olijuseju/videocoche/Jors_1/360Robot/Pinout Schematic.jpg

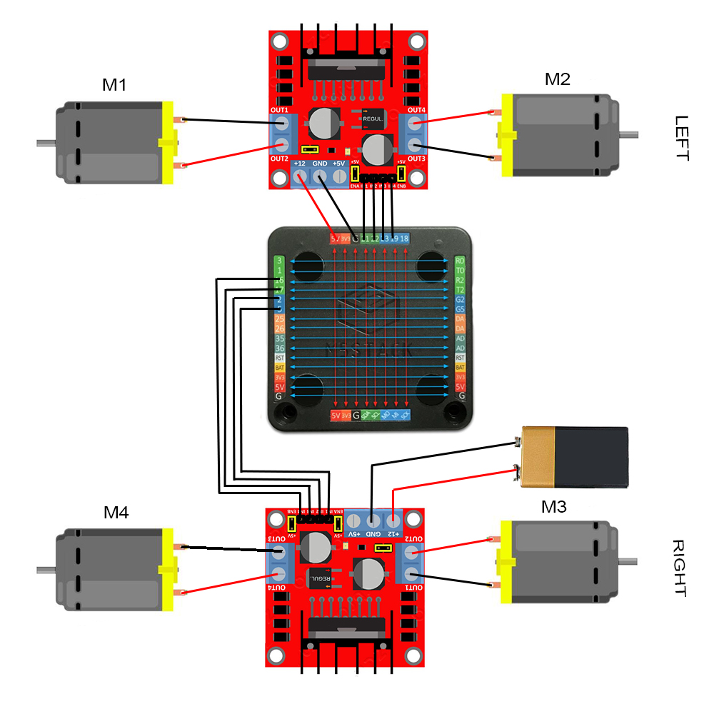
Jors_1/360Robot/Pinout Schematic.jpg
