olijuseju/videocoche/Jors_1/360Robot/README.md

# 360Robot
# Why 360Robot?
This project was born from the need to remotely control the movement of a camera for making 360º videos . With the aim of obtaining a recording at eye level without the need of human resources. It consists in the design and construction of a motorized mobile support remotely controlled by wireless connection. This type of recording technology is becoming really popular and we wanted to be part of this movement.

# How did we make it?
Our first idea was to make it using Arduino Genuino Uno with ESP32 chip, however we wanted to make it different. So instead of that we decided to use M5STACK which is an open source enclosed modular toolkit with ESP32:

http://m5stack.com/.

We also used 2 motor shields, each one for 2 motors:

https://www.iberobotics.com/producto/modulo-driver-motores-l298n-doble-puente-h/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

Last but not least, the robot tank. Which includes the chassis and the motors for the robot:

https://es.aliexpress.com/item/T900-4WD-Metal-Wall-E-Tank-Track-Caterpillar-Chassis-tracked-vehicle-mobile-platform-crawler-walee-diy/32669806063.html

# Design Diagram
360robot 5

# Pinout Schematic
pinout schematic
