olijuseju/videocoche/conexionado.PNG

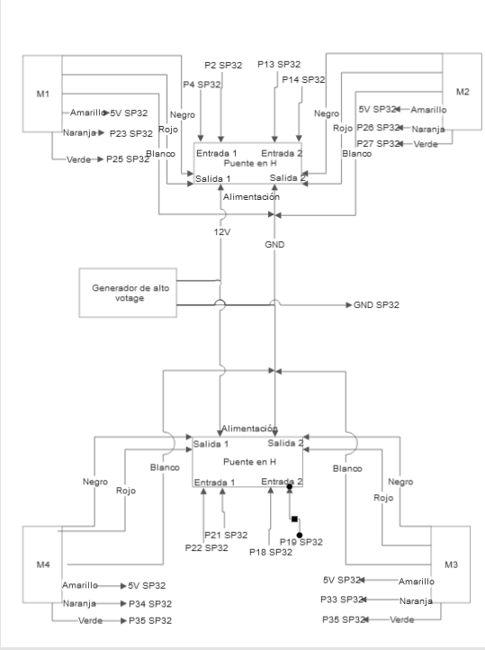
conexionado.PNG
