olijuseju/videocoche/Jors_1/360Robot/360Robot Diagram.png

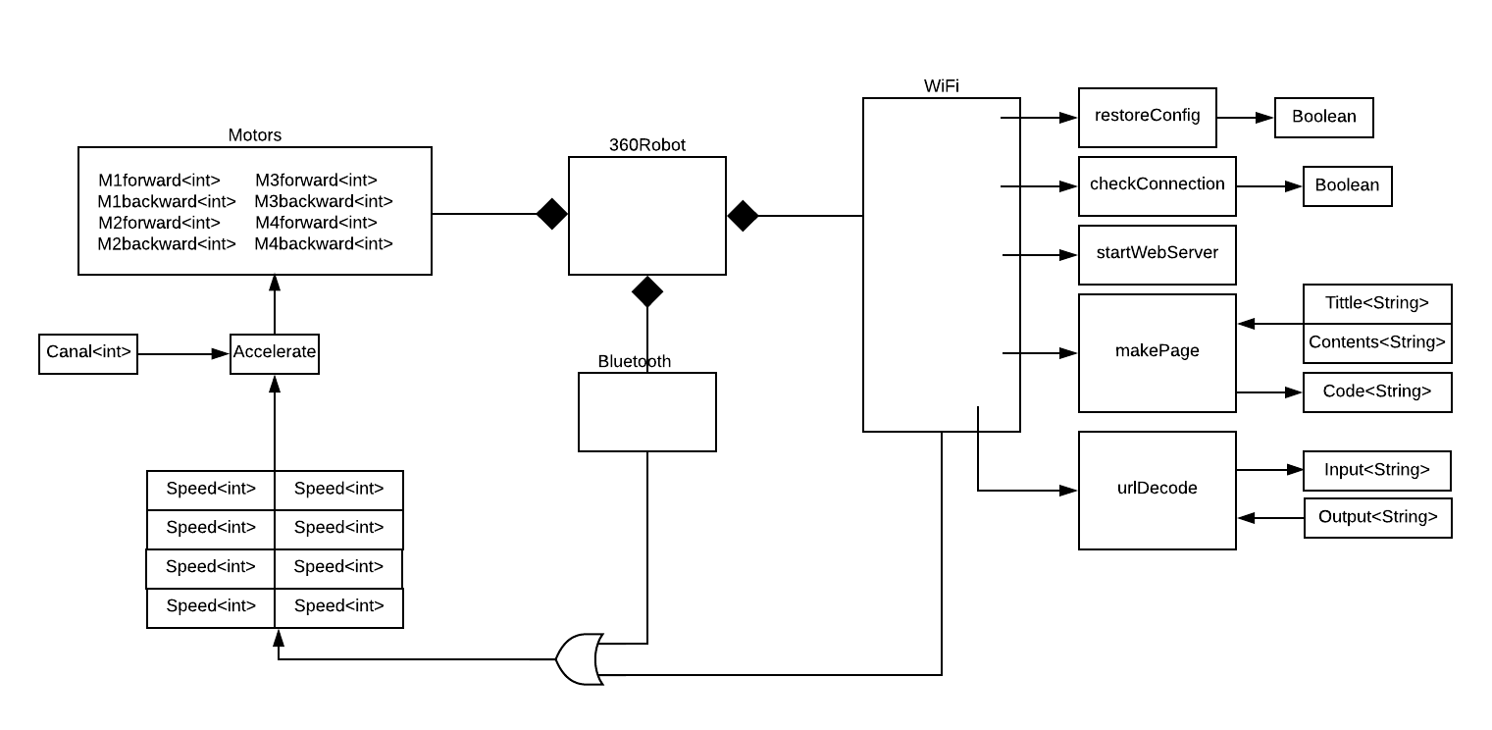
Jors_1/360Robot/360Robot Diagram.png
