olijuseju/videocoche/Jors_1/360Robot/360WebClient/8.png

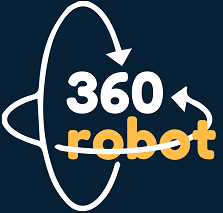
Jors_1/360Robot/360WebClient/8.png
