olijuseju/videocoche/material.xlsx

Material | Cantidad | Observaciones
Controladores ESP32-WROOM-32 Adafruit | 4
Controladores ESP32s Sparkfun | 1 | Está siendo utilizado en la primera versión del robot
Rollo de cable blanco 100m | 1
Rollo de cable negro 100m | 3
Rollo de cable rojo 100m | 1
Contactos terminales para crimpar cables | 100 | Se han utilizado aproximadamente 20
Paquete de 10 resistencias | 10 | De valores desde 100 Ω a 1MΩ
Conectores , PH, Receptáculo, 6 Vías, 2 mm | 10 | Se han utilizado 4 para el montaje del robot
Virolas para cables | 2000 | Colores: Blanco (0.5mm2) Gris (0.75mm2) Rojo (1mm2) Negro (1.5mm2) Azul (2.5mm2) Gris claro (4mm2) Amarillo (6mm2) Rojo (10mm2)
Crimpadora de cables para virolas | 1 | Utilizado para crimpar los cables a las virolas, no a los conectores
Peladora de cables | 1
Destornillador | 1 | Con 14 puntas diferentes
Cutter | 1
Contactos para PCB 10 vías | 10 | Usados 2 en la pcb
Contactos para PCB 3 vías | 10 | Usado 1 en la pcb
Condensadores de 1μF y 6.3V para soldar en PCB | 10 | 1 usado en la PCB
