olijuseju/videocoche/conexiones_videocoche.pdf

+

# BATERIA

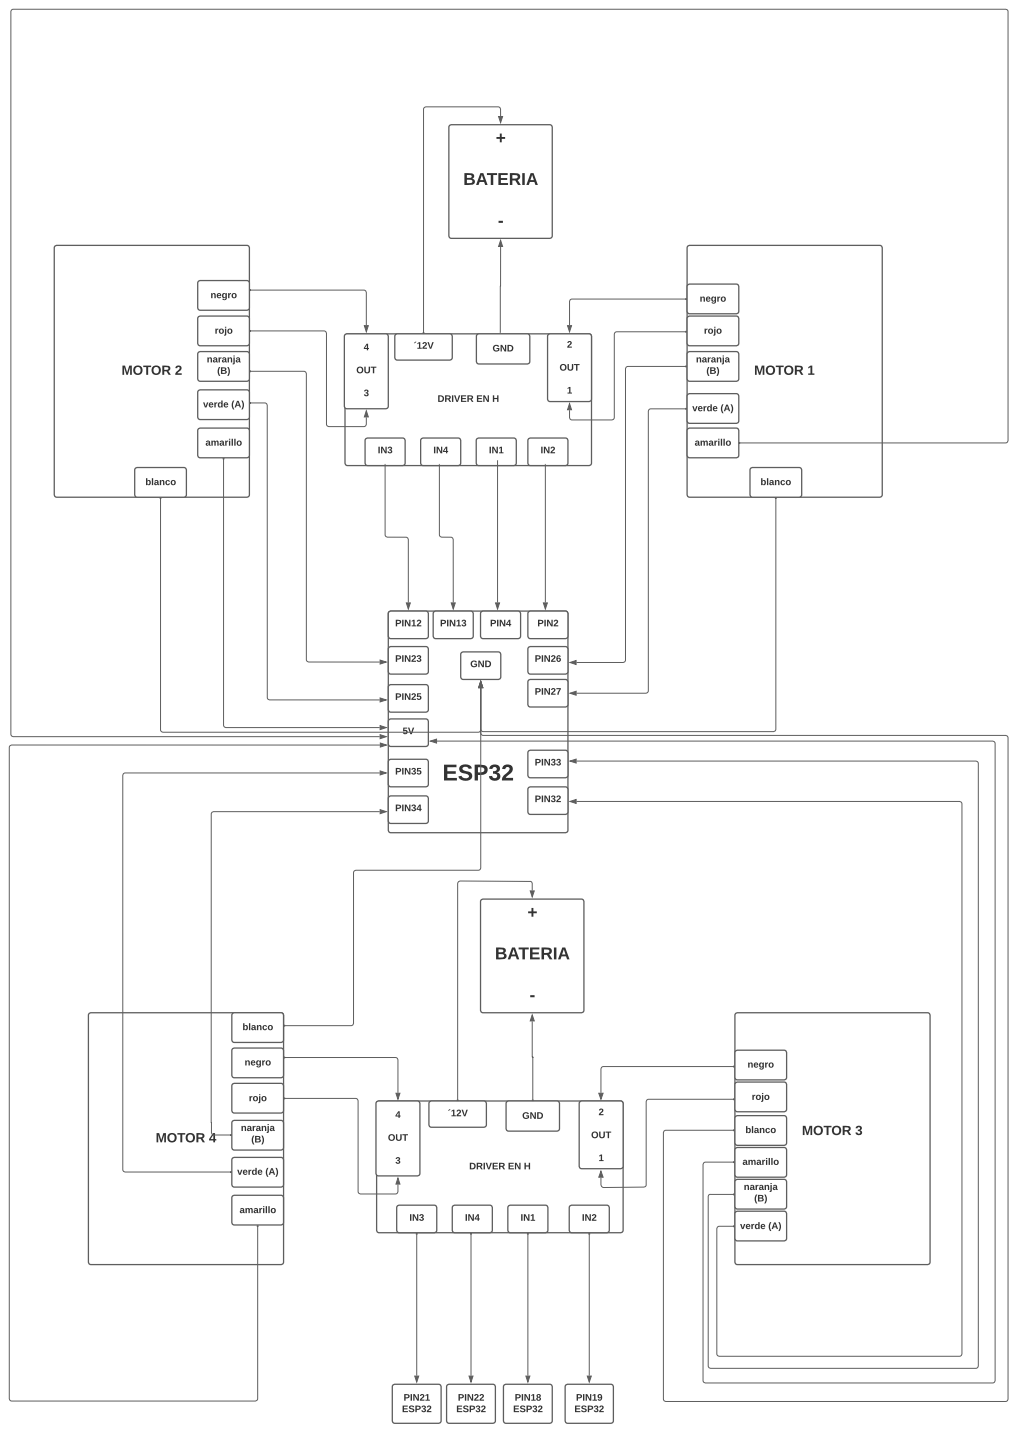
[picture p8: page 1]
ESP32; PIN12; PIN13; PIN4; PIN2; DRIVER EN H; OUT; MOTOR 2; blanco; negro; naranja (B); rojo; verde (A); amarillo; MOTOR 1; PIN25; PIN23; GND; MOTOR 4; MOTOR 3; BATERIA; PIN35; PIN34; PIN27; PIN26 GND; PIN33; PIN32; PIN21 ESP32; PIN22 ESP32; PIN18 ESP32; PIN19 ESP32
