olijuseju/videocoche/Robot fernando.pdf

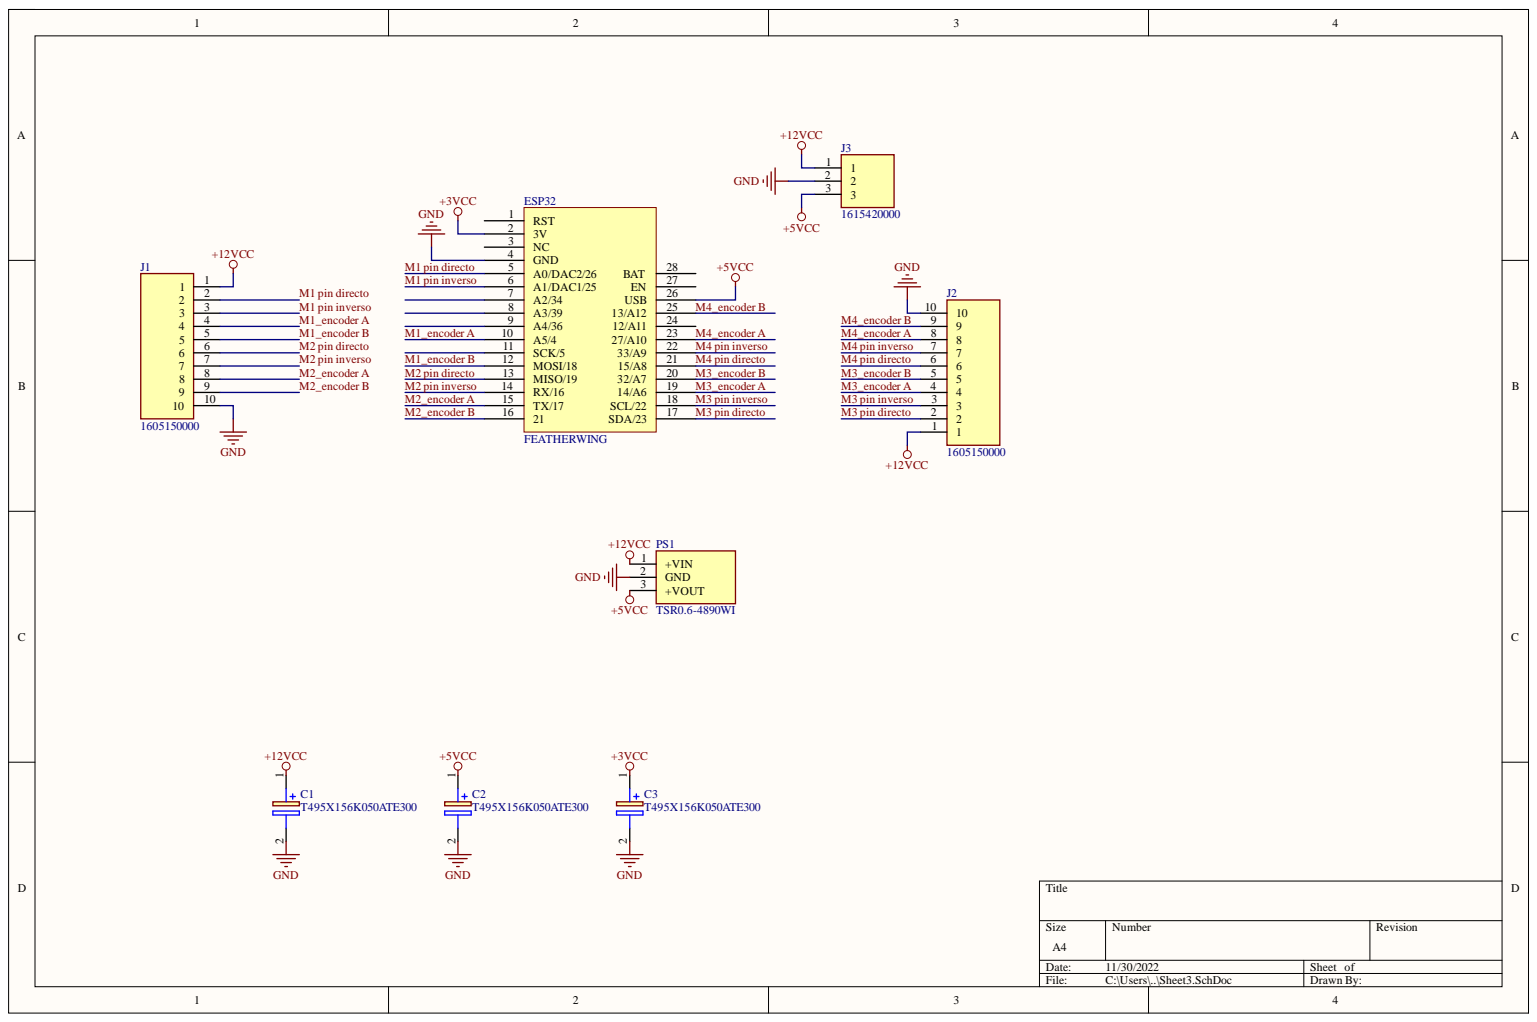
[picture p9: page 1]

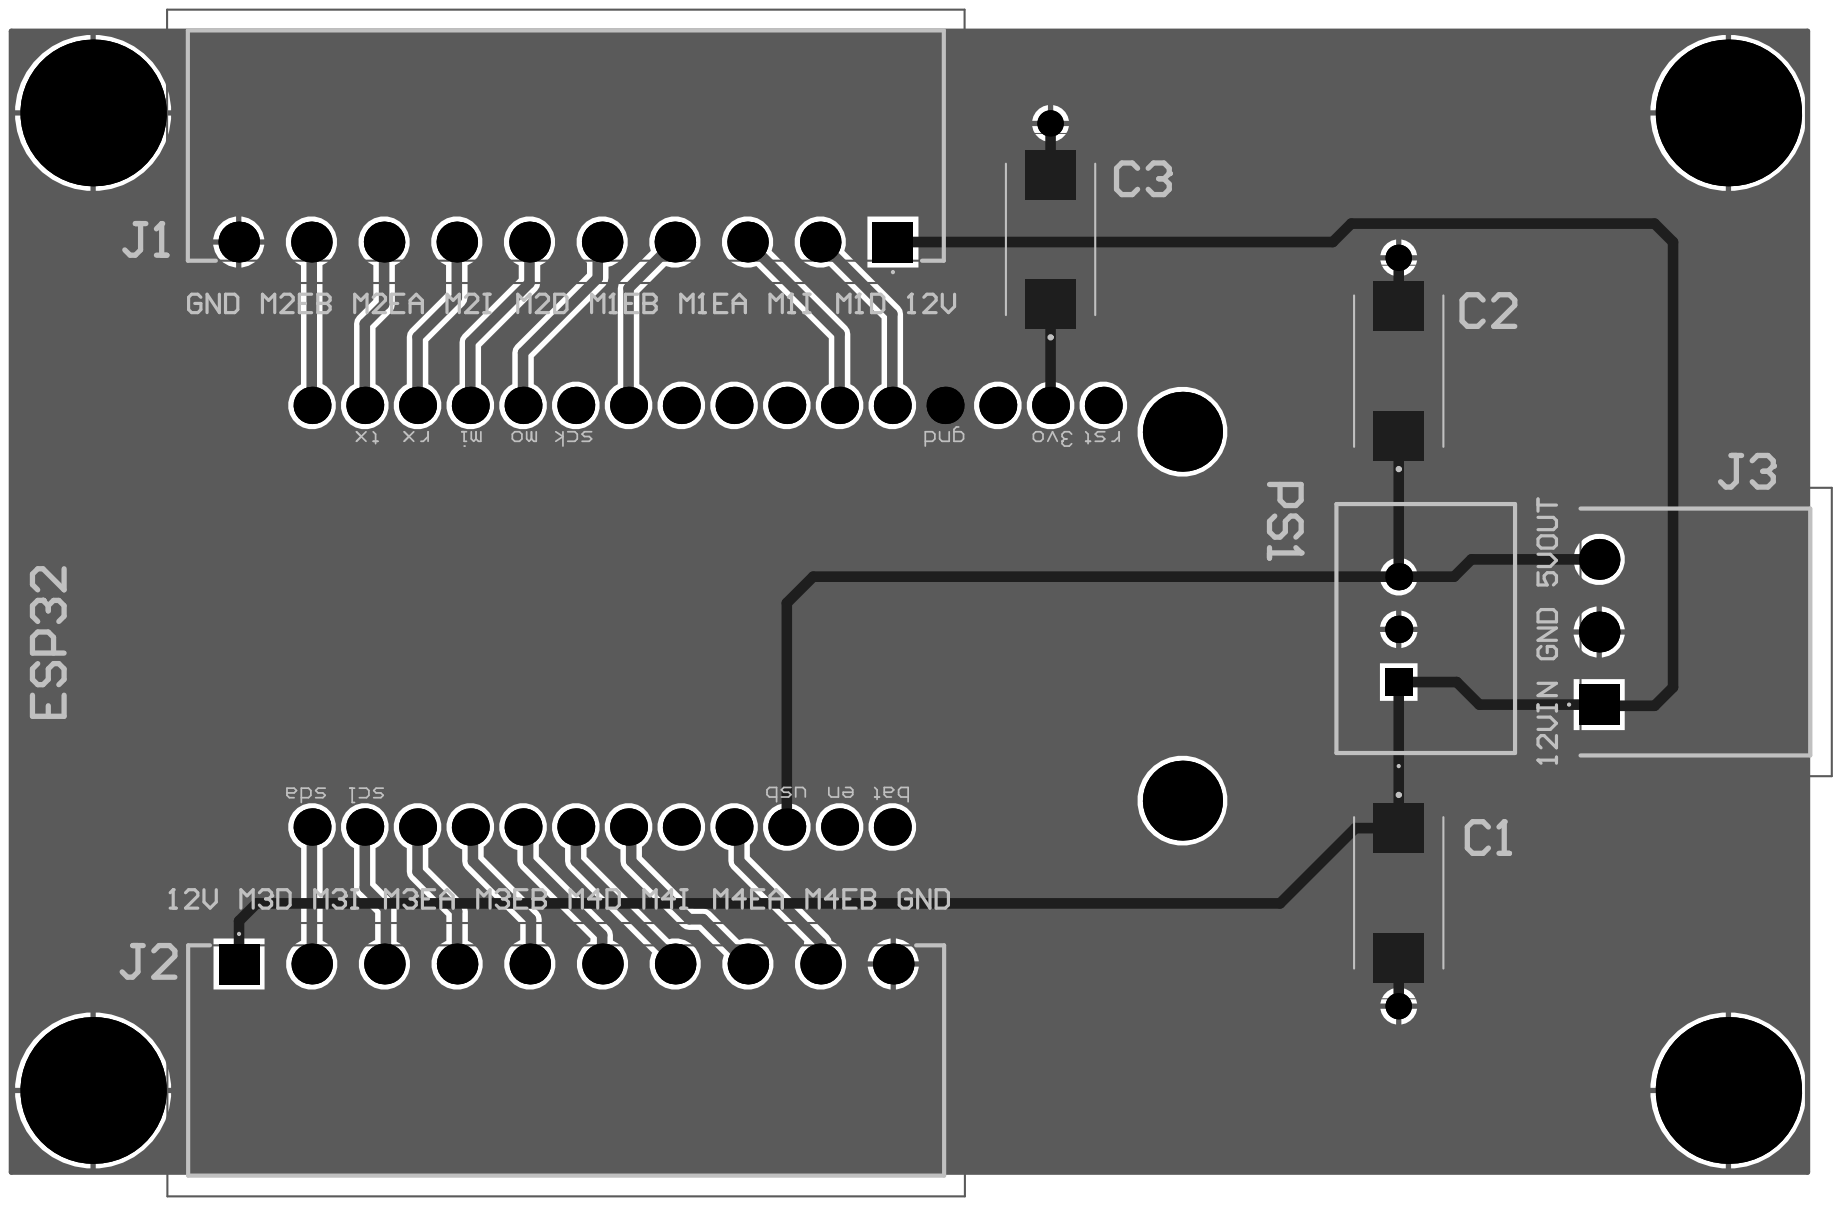
[picture p10: page 2]
