olijuseju/videocoche/Jors_1/360Robot/360Robot.ino

/*
   Developed by Makers Gandía in colaboration with Immersive Interactive Lab.
   Authors: Alejandro Marco Ibáñez, Maria Balagué, Leonardo Rodríguez, Alejandro Castilla García, Jair López Gutiérrez
*/


///////////////////////////////////////////////////////////////////////////////////////////////////////////////////////////////////////////////////////////////////////
/////////////////////////////////////////////////////////////////////////VARIABLES/////////////////////////////////////////////////////////////////////////////////////
///////////////////////////////////////////////////////////////////////////////////////////////////////////////////////////////////////////////////////////////////////

//////////////////////////////////////////////////////////////////////////////////////////////////////////////////////INCLUDE

#include <M5Stack.h>
#include <WiFi.h>
#include <ESPmDNS.h>
#include <WiFiClient.h>
#include "WebServer.h"
#include <Preferences.h>

//////////////////////////////////////////////////////////////////////////////////////////////////////////////////////END INCLUDE

//////////////////////////////////////////////////////////////////////////////////////////////////////////////////////DEFINE MOTOR

// use 13 bit precission for LEDC resolution
#define resolution  13

// use 5000 Hz as a LEDC base frequency
#define frec     40000

//////////////////////////////////////////////////////////////////////////M1
// use first channel of 16 channels (started from zero)
#define canal_0     0

// fade LED PIN (replace with LED_BUILTIN constant for built-in LED)
#define LED_PIN21            21

//////////////////////////////////////////////////////////////////////////M1 BACK

// use second channel of 16 channels (started from zero)
#define canal_1     1

// fade LED PIN (replace with LED_BUILTIN constant for built-in LED)
#define LED_PIN22            22

//////////////////////////////////////////////////////////////////////////M2

// use third channel of 16 channels (started from zero)
#define canal_2     2

// fade LED PIN (replace with LED_BUILTIN constant for built-in LED)
#define LED_PIN23            23

//////////////////////////////////////////////////////////////////////////M2 BACK


// use fourth channel of 16 channels (started from zero)
#define canal_3     3


// fade LED PIN (replace with LED_BUILTIN constant for built-in LED)
#define LED_PIN19            19

//////////////////////////////////////////////////////////////////////////M3

// use fifth channel of 16 channels (started from zero)
#define canal_4     4

// fade LED PIN (replace with LED_BUILTIN constant for built-in LED)
#define LED_PIN5            5

//////////////////////////////////////////////////////////////////////////M3 BACK

// use sixth channel of 16 channels (started from zero)
#define canal_5     5

// fade LED PIN (replace with LED_BUILTIN constant for built-in LED)
#define LED_PIN2            2

//////////////////////////////////////////////////////////////////////////M4

// use seventh channel of 16 channels (started from zero)
#define canal_6     6

// fade LED PIN (replace with LED_BUILTIN constant for built-in LED)
#define LED_PIN17            17

//////////////////////////////////////////////////////////////////////////M4 BACK

// use eight channel of 16 channels (started from zero)
#define canal_7     7

// fade LED PIN (replace with LED_BUILTIN constant for built-in LED)
#define LED_PIN16            16

//////////////////////////////////////////////////////////////////////////////////////////////////////////////////////END DEFINE MOTOR

//////////////////////////////////////////////////////////////////////////////////////////////////////////////////////MOTOR VARIABLES

float speedMultiplier = 10;
float speedMultiplierBackup = 10;
bool smartControl = false;
float smartValue = 0;

int M1forward = 0;
int M1backward = 0;

int M2forward = 0;
int M2backward = 0;

int M3forward = 0;
int M3backward = 0;

int M4forward = 0;
int M4backward = 0;

//////////////////////////////////////////////////////////////////////////////////////////////////////////////////////END MOTOR VARIABLES

//////////////////////////////////////////////////////////////////////////////////////////////////////////////////////WIFI VARIABLES

const IPAddress apIP(192, 168, 4, 1);
const char* apSSID = "M5STACK_SETUP";
boolean settingMode;
String ssidList;
String wifi_ssid;
String wifi_password;

// DNSServer dnsServer;
WebServer webServer(80);

// wifi config store
Preferences preferences;

//////////////////////////////////////////////////////////////////////////////////////////////////////////////////////END WIFI VARIABLES

/////////////////////////////////////////////////////////////////////////////////////////////////////////////////////////////////////////////////////////////////////
///////////////////////////////////////////////////////////////////////////////METHODS///////////////////////////////////////////////////////////////////////////////
/////////////////////////////////////////////////////////////////////////////////////////////////////////////////////////////////////////////////////////////////////

//////////////////////////////////////////////////////////////////////////////////////////////////////////////////////ACCELERATE

void accelerate(uint8_t channel, uint32_t value, uint32_t valueMax = 255) {
  // calculate duty, 8191 from 2 ^ 13 - 1
  
  value = value * speedMultiplier;
  uint32_t duty = (8191 / valueMax) * value;
  //uint32_t duty = (8191 / valueMax) * min(value, valueMax);

  // write duty to LEDC
  ledcWrite(channel, duty);
}

//////////////////////////////////////////////////////////////////////////////////////////////////////////////////////END ACCELERATE

//////////////////////////////////////////////////////////////////////////////////////////////////////////////////////RESTORECONFIG

boolean restoreConfig() {
  wifi_ssid = preferences.getString("WIFI_SSID");
  wifi_password = preferences.getString("WIFI_PASSWD");
  Serial.print("WIFI-SSID: ");
  M5.Lcd.print("WIFI-SSID: ");
  Serial.println(wifi_ssid);
  M5.Lcd.println(wifi_ssid);
  Serial.print("WIFI-PASSWD: ");
  M5.Lcd.print("WIFI-PASSWD: ");
  Serial.println(wifi_password);
  M5.Lcd.println(wifi_password);
  WiFi.begin(wifi_ssid.c_str(), wifi_password.c_str());

  if (wifi_ssid.length() > 0) {
    return true;
  } else {
    return false;
  }
}

//////////////////////////////////////////////////////////////////////////////////////////////////////////////////////END RESTORECONFIG

//////////////////////////////////////////////////////////////////////////////////////////////////////////////////////CHECKCONNECTION

boolean checkConnection() {
  int count = 0;
  Serial.print("Waiting for Wi-Fi connection");
  M5.Lcd.print("Waiting for Wi-Fi connection");
  while ( count < 30 ) {
    if (WiFi.status() == WL_CONNECTED) {
      Serial.println();
      M5.Lcd.println();
      Serial.println("Connected!");
      M5.Lcd.println("Connected!");
      return (true);
    }
    delay(500);
    Serial.print(".");
    M5.Lcd.print(".");
    count++;
  }
  Serial.println("Timed out.");
  M5.Lcd.println("Timed out.");
  return false;
}

//////////////////////////////////////////////////////////////////////////////////////////////////////////////////////END CHECKCONNECTION

//////////////////////////////////////////////////////////////////////////////////////////////////////////////////////STARTWEBSERVER

void startWebServer() {
  if (settingMode) {
    Serial.print("Starting Web Server at ");
    M5.Lcd.print("Starting Web Server at ");
    Serial.println(WiFi.softAPIP());
    M5.Lcd.println(WiFi.softAPIP());
    webServer.on("/settings", []() {
      String s = "<h1>Wi-Fi Settings</h1><p>Please enter your password by selecting the SSID.</p>";
      s += "<form method=\"get\" action=\"setap\"><label>SSID: </label><select name=\"ssid\">";
      s += ssidList;
      s += "</select><br>Password: <input name=\"pass\" length=64 type=\"password\"><input type=\"submit\"></form>";
      webServer.send(200, "text", makePage("Wi-Fi Settings", s));
    });

    // INCREASE SPEED
    webServer.on("/moreSpeed", []() {
      if(speedMultiplierBackup < 10) speedMultiplierBackup++;
//      speedMultiplier = (speedMultiplier >= 10?10:speedMultiplier++);
      webServer.send(200, "application/json", "{\"Speed\":\""+(String)speedMultiplier+(String)"\"}");
    });
    
    // DECREASE SPEED
    webServer.on("/lessSpeed", []() {
      if(speedMultiplierBackup>1) speedMultiplierBackup--;
      webServer.send(200, "application/json", "{\"Speed\":\""+(String)speedMultiplier+(String)"\"}");
    });
       
    // GO FORWARD
    webServer.on("/smartControl", []() {
       // LCD display
      smartControl = !smartControl;
      speedMultiplier = 0;
      smartValue = 0;
      webServer.send(200, "application/json", "{\"Smart Control\":\""+(String)smartControl+(String)"\"}");
    });
    
    // GO FORWARD
    webServer.on("/forward", []() {
       // LCD display
      M5.Lcd.print("FORWARD");
      Serial.println("FORWARD");
       if(smartControl) smartValue = 0.05;
      
       M1forward = 25;
       M2forward = 25;
       M3forward = 25;
       M4forward = 25;

       M1backward = 0;
       M2backward = 0;
       M3backward = 0;
       M4backward = 0;
       
      webServer.send(200, "application/json", "{\"Confirm\":\"true\"}");
    });

    // GO FORWARD
    webServer.on("/rightForward", []() {
       // LCD display
       if(smartControl) smartValue = 0.05;
      M5.Lcd.print("FORWARD");
      Serial.println("FORWARD");
       M1forward = 25;
       M2forward = 17;
       M3forward = 17;
       M4forward = 25;

       M1backward = 0;
       M2backward = 0;
       M3backward = 0;
       M4backward = 0;
       
      webServer.send(200, "application/json", "{\"Confirm\":\"true\"}");
    });
    
    // GO FORWARD
    webServer.on("/leftForward", []() {
       // LCD display
       if(smartControl) smartValue = 0.05;
      M5.Lcd.print("FORWARD");
      Serial.println("FORWARD");
       M1forward = 17;
       M2forward = 25;
       M3forward = 25;
       M4forward = 17;

       M1backward = 0;
       M2backward = 0;
       M3backward = 0;
       M4backward = 0;
       
      webServer.send(200, "application/json", "{\"Confirm\":\"true\"}");
    });

    // STOP
    webServer.on("/stop", []() {
       // LCD display
       if(smartControl) smartValue = -0.05;
       else{
       M1forward = 0;
       M2forward = 0;
       M3forward = 0;
       M4forward = 0;

      M1backward = 0;
      M2backward = 0;
      M3backward = 0;
      M4backward = 0;
       }
      M5.Lcd.print("STOP");
      webServer.send(200, "application/json", "{\"Confirm\":\"true\"}");
    });

    //TURN RIGHT
    webServer.on("/right", []() {
       // LCD display
       if(smartControl) smartValue = 0.05;
      M5.Lcd.print("right");
      M1forward = 25;
      M2backward = 10;
      M3backward = 10;
      M4forward = 25;

      M1backward = 0;
      M2forward = 0;
      M3forward = 0;
      M4backward = 0;
      webServer.send(200, "application/json", "{\"Confirm\":\"true\"}");
    });
 
    //TURN LEFT
    webServer.on("/left", []() {
       // LCD display
       if(smartControl) smartValue = 0.05;
      M5.Lcd.print("left");
      M1backward = 10;
      M2forward = 25;
      M3forward = 25;
      M4backward = 10;

      M1forward = 0;
      M2backward = 0;
      M3backward = 0;
      M4forward = 0;
      webServer.send(200, "application/json", "{\"Confirm\":\"true\"}");
    });

    //GO BACKWARD
    webServer.on("/backward", []() {
       // LCD display
      M5.Lcd.print("BACKWARD");
       if(smartControl) smartValue = 0.05;
      M1forward = 0;
      M2forward = 0;
      M3forward = 0;
      M4forward = 0;

      M1backward = 25;
      M2backward = 25;
      M3backward = 25;
      M4backward = 25;
      webServer.send(200, "application/json", "{\"Confirm\":\"true\"}");
    });


    // GO FORWARD
    webServer.on("/rightBackward", []() {
       // LCD display
       if(smartControl) smartValue = 0.05;
      M5.Lcd.print("FORWARD");
      Serial.println("FORWARD");
       M1forward = 0;
       M2forward = 0;
       M3forward = 0;
       M4forward = 0;

      M1backward = 25;
      M2backward = 17;
      M3backward = 17;
      M4backward = 25;
       
      webServer.send(200, "application/json", "{\"Confirm\":\"true\"}");
    });
    
    // GO FORWARD
    webServer.on("/leftBackward", []() {
       // LCD display
       if(smartControl) smartValue = 0.05;
      M5.Lcd.print("FORWARD");
      Serial.println("FORWARD");
       M1forward = 0;
       M2forward = 0;
       M3forward = 0;
       M4forward = 0;

      M1backward = 17;
      M2backward = 25;
      M3backward = 25;
      M4backward = 17;
       
      webServer.send(200, "application/json", "{\"Confirm\":\"true\"}");
    });

    webServer.on("/setap", []() {
      String ssid = urlDecode(webServer.arg("ssid"));
      Serial.print("SSID: ");
      M5.Lcd.print("SSID: ");
      Serial.println(ssid);
      M5.Lcd.println(ssid);
      String pass = urlDecode(webServer.arg("pass"));
      Serial.print("Password: ");
      M5.Lcd.print("Password: ");
      Serial.println(pass);
      M5.Lcd.println(pass);
      Serial.println("Writing SSID to EEPROM...");
      M5.Lcd.println("Writing SSID to EEPROM...");

      // Store wifi config
      Serial.println("Writing Password to nvr...");
      M5.Lcd.println("Writing Password to nvr...");
      preferences.putString("WIFI_SSID", ssid);
      preferences.putString("WIFI_PASSWD", pass);

      Serial.println("Write nvr done!");
      M5.Lcd.println("Write nvr done!");
      String s = "<h1>Setup complete.</h1><p>device will be connected to \"";
      s += ssid;
      s += "\" after the restart.";
      webServer.send(200, "text/html", makePage("Wi-Fi Settings", s));
      delay(3000);
      ESP.restart();
    });
    webServer.onNotFound([]() {
      String s = "<h1>AP mode</h1><p><a href=\"/settings\">Wi-Fi Settings</a></p>";
      webServer.send(200, "text/html", makePage("AP mode", s));
    });
  }
  else {
    Serial.print("Starting Web Server at ");
    M5.Lcd.print("Starting Web Server at ");
    Serial.println(WiFi.localIP());
    M5.Lcd.println(WiFi.localIP());
    webServer.on("/", []() {
      String s = "<h1>STA mode</h1><p><a href=\"/reset\">Reset Wi-Fi Settings</a></p>";
      webServer.send(200, "text/html", makePage("STA mode", s));
    });
    webServer.on("/reset", []() {
      // reset the wifi config
      preferences.remove("WIFI_SSID");
      preferences.remove("WIFI_PASSWD");
      String s = "<h1>Wi-Fi settings was reset.</h1><p>Please reset device.</p>";
      webServer.send(200, "text/html", makePage("Reset Wi-Fi Settings", s));
      delay(3000);
      ESP.restart();
    });
  }
  webServer.begin();
}

//////////////////////////////////////////////////////////////////////////////////////////////////////////////////////END STARTWEBSERVER


//////////////////////////////////////////////////////////////////////////////////////////////////////////////////////MAKEPAGE

String makePage(String title, String contents) {
  String s = "<!DOCTYPE html><html><head>";
  s += "<meta name=\"viewport\" content=\"width=device-width,user-scalable=0\">";
  s += "<title>";
  s += title;
  s += "</title></head><body>";
  s += contents;
  s += "</body></html>";
  return s;
}

//////////////////////////////////////////////////////////////////////////////////////////////////////////////////////END MAKEPAGE

//////////////////////////////////////////////////////////////////////////////////////////////////////////////////////URLDECODE

String urlDecode(String input) {
  String s = input;
  s.replace("%20", " ");
  s.replace("+", " ");
  s.replace("%21", "!");
  s.replace("%22", "\"");
  s.replace("%23", "#");
  s.replace("%24", "$");
  s.replace("%25", "%");
  s.replace("%26", "&");
  s.replace("%27", "\'");
  s.replace("%28", "(");
  s.replace("%29", ")");
  s.replace("%30", "*");
  s.replace("%31", "+");
  s.replace("%2C", ",");
  s.replace("%2E", ".");
  s.replace("%2F", "/");
  s.replace("%2C", ",");
  s.replace("%3A", ":");
  s.replace("%3A", ";");
  s.replace("%3C", "<");
  s.replace("%3D", "=");
  s.replace("%3E", ">");
  s.replace("%3F", "?");
  s.replace("%40", "@");
  s.replace("%5B", "[");
  s.replace("%5C", "\\");
  s.replace("%5D", "]");
  s.replace("%5E", "^");
  s.replace("%5F", "-");
  s.replace("%60", "`");
  return s;
}

//////////////////////////////////////////////////////////////////////////////////////////////////////////////////////END URLDECODE

//////////////////////////////////////////////////////////////////////////////////////////////////////////////////////SETUPMODE


void setup() {
  M5.begin();
  M5.Speaker.setVolume(0);
  
  M5.Lcd.setTextColor(GREEN);
  M5.Lcd.setTextSize(4);

  speedMultiplierBackup = speedMultiplier = 5;

  M1forward = 0;
  M2forward = 0;
  M3forward = 0;
  M4forward = 0;
  
  M1backward = 0;
  M2backward = 0;
  M3backward = 0;
  M4backward = 0;

  // put your setup code here, to run once:
  // Setup resolution and attach resolution to a led pin

  ledcSetup(canal_0, frec, resolution);
  ledcAttachPin(LED_PIN16, canal_0);

  ledcSetup(canal_1, frec, resolution);
  ledcAttachPin(LED_PIN17, canal_1);

  ledcSetup(canal_2, frec, resolution);
  ledcAttachPin(LED_PIN23, canal_2);
  
  ledcSetup(canal_3, frec, resolution);
  ledcAttachPin(LED_PIN19, canal_3);

  ledcSetup(canal_4, frec, resolution);
  ledcAttachPin(LED_PIN5, canal_4);

  ledcSetup(canal_5, frec, resolution);
  ledcAttachPin(LED_PIN2, canal_5);

  ledcSetup(canal_6, frec, resolution);
  ledcAttachPin(LED_PIN21, canal_6);

  ledcSetup(canal_7, frec, resolution);
  ledcAttachPin(LED_PIN22, canal_7);

  preferences.begin("wifi-config");
  delay(10);
  if (restoreConfig()) {
    if (checkConnection()) {
      settingMode = false;
      startWebServer();
      return;
    }
  }
  settingMode = true;
  setupMode();
  // LCD display
  M5.Lcd.print("M5Stack iniciado");

}

//////////////////////////////////////////////////////////////////////////////////////////////////////////////////////END SETUPMODE

//////////////////////////////////////////////////////////////////////////////////////////////////////////////////////LOOP

int cont = 0;

void loop() {
  // LCD display
  
  if (settingMode) {
  }
  webServer.handleClient();

  if(smartControl){
    if(smartValue < 0){
      if(speedMultiplier >= 0){
        speedMultiplier += smartValue;
        Serial.println(speedMultiplier);
      }
     } else if (smartValue > 0){
      if(speedMultiplier <= speedMultiplierBackup){  
        speedMultiplier += smartValue;
        Serial.println(speedMultiplier);
      } else {
        speedMultiplier -= smartValue;
        Serial.println(speedMultiplier);
      }
    }
  } else {
    speedMultiplier = speedMultiplierBackup;
  }

  if (speedMultiplier < 0) speedMultiplier = 0;
  
  //m1
  accelerate(canal_0, M1forward);
  accelerate(canal_1, M1backward);
  //m2
  accelerate(canal_2, M2forward);
  accelerate(canal_3, M2backward);
  //m3
  accelerate(canal_4, M3forward);
  accelerate(canal_5, M3backward);
  //m4
  accelerate(canal_6, M4forward);
  accelerate(canal_7, M4backward);
        delay(50);
}

//////////////////////////////////////////////////////////////////////////////////////////////////////////////////////END LOOP

//////////////////////////////////////////////////////////////////////////////////////////////////////////////////////SETUP

void setupMode() {
  WiFi.mode(WIFI_MODE_STA);
  WiFi.disconnect();
  delay(100);
  int n = WiFi.scanNetworks();
  delay(100);
  Serial.println("");
  M5.Lcd.println("");
  for (int i = 0; i < n; ++i) {
    ssidList += "<option value=\"";
    ssidList += WiFi.SSID(i);
    ssidList += "\">";
    ssidList += WiFi.SSID(i);
    ssidList += "</option>";
  }
  delay(100);
  WiFi.softAPConfig(apIP, apIP, IPAddress(255, 255, 255, 0));
  WiFi.softAP(apSSID);
  WiFi.mode(WIFI_MODE_AP);
  // WiFi.softAPConfig(IPAddress local_ip, IPAddress gateway, IPAddress subnet);
  // WiFi.softAP(const char* ssid, const char* passphrase = NULL, int channel = 1, int ssid_hidden = 0);
  // dnsServer.start(53, "*", apIP);
  startWebServer();
  Serial.print("Starting Access Point at \"");
  M5.Lcd.print("Starting Access Point at \"");
  Serial.print(apSSID);
  M5.Lcd.print(apSSID);
  Serial.println("\"");
  M5.Lcd.println("\"");
}
//////////////////////////////////////////////////////////////////////////////////////////////////////////////////////END SETUP
